makerhqsac/piprog/images/assembly4.png

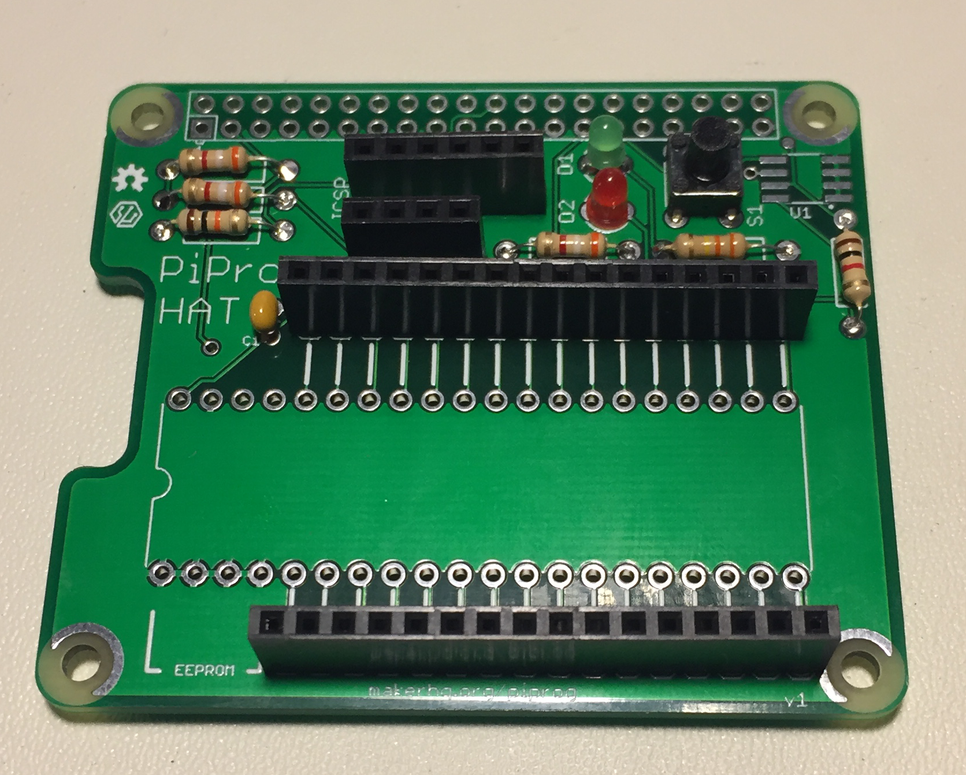
images/assembly4.png
