makerhqsac/piprog/images/assembly2b.png

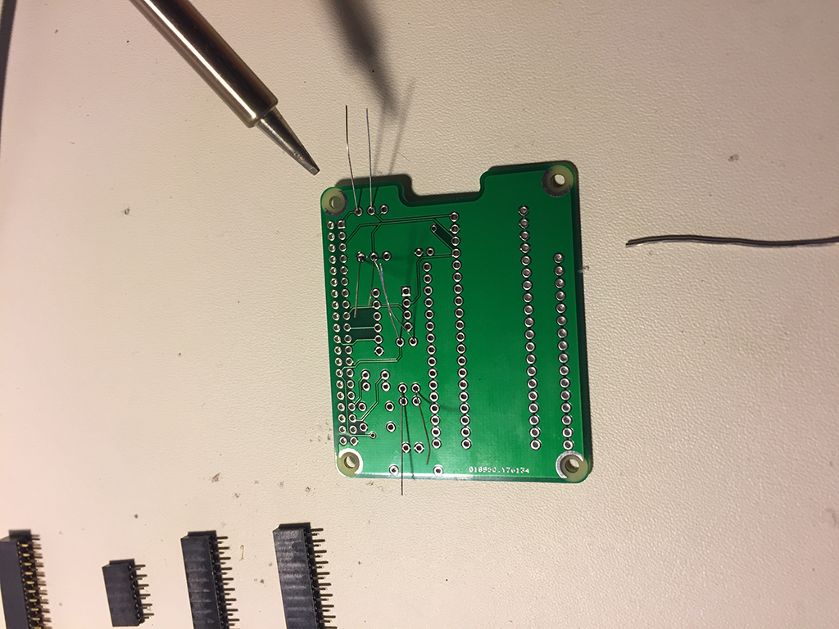
images/assembly2b.png
