makerhqsac/piprog/README.md

# piprog
PiProg - Raspberry Pi EEPROM and ICSP Programmer HAT
