makerhqsac/piprog/hardware/piprog_v1.pdf

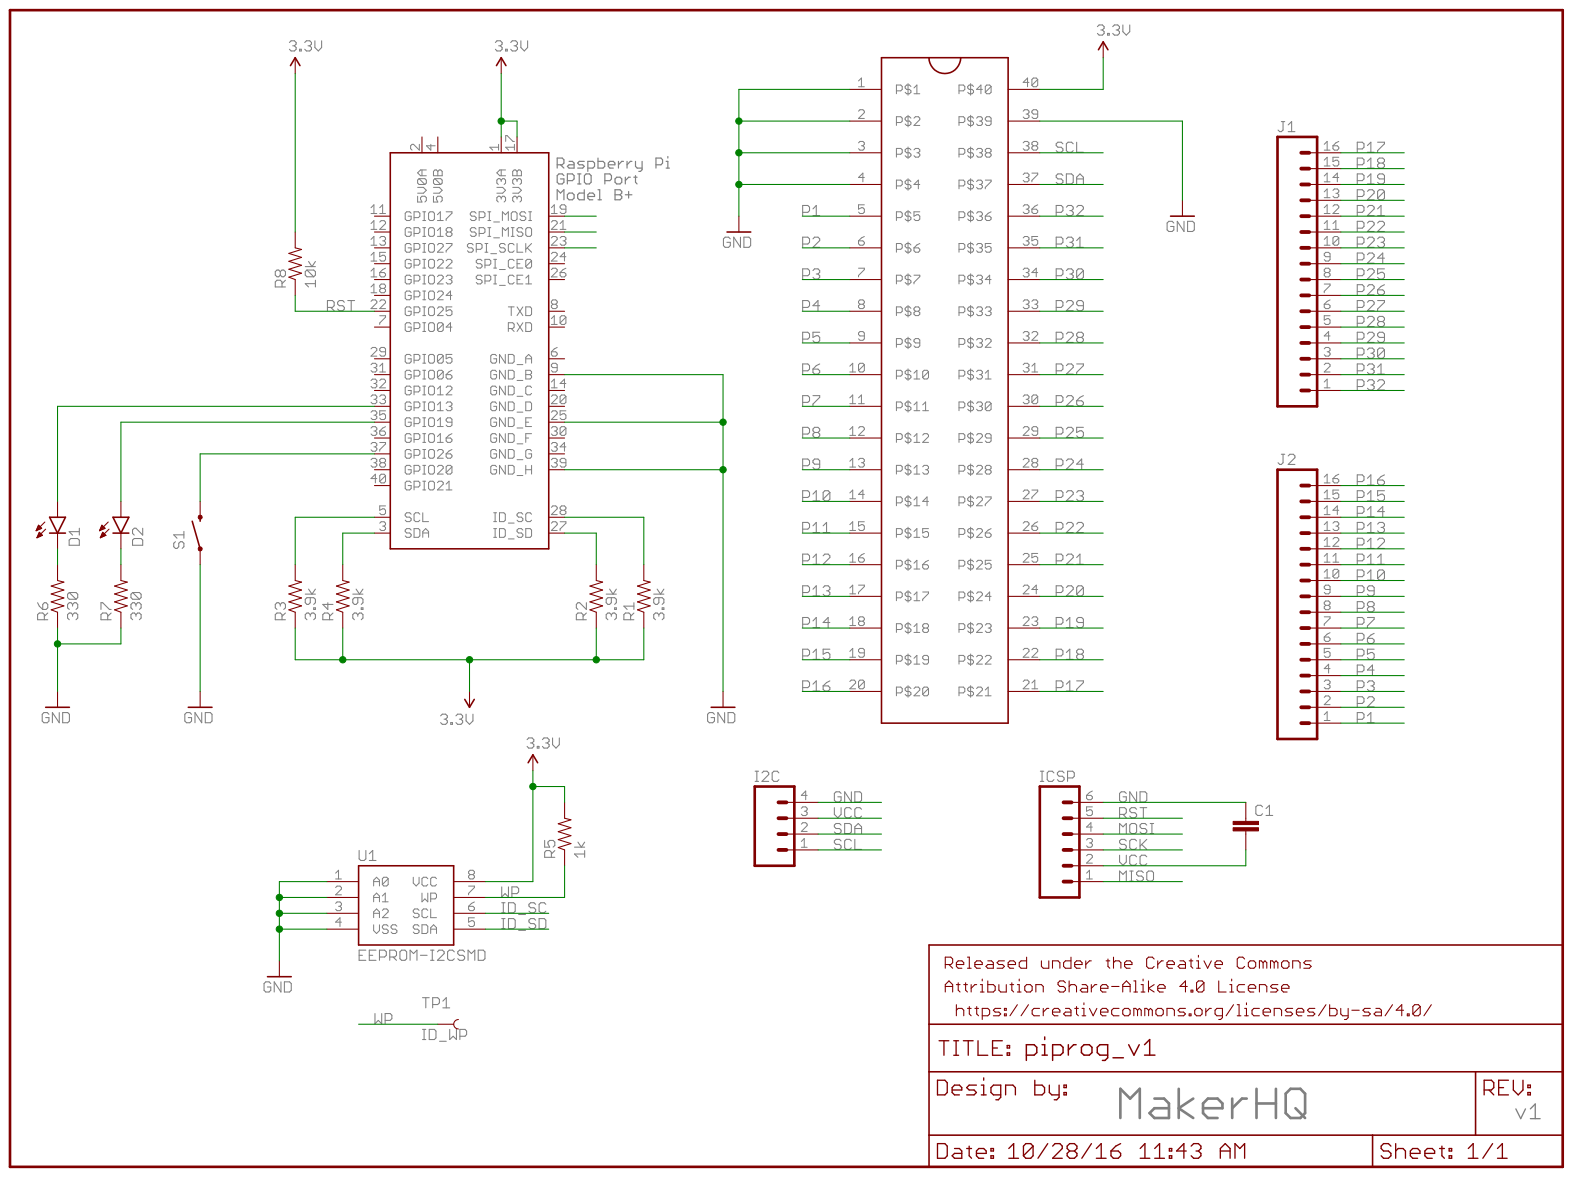
[picture p3: page 1]
