makerhqsac/piprog/hardware/piprog_v1.brd

## EAGLE design hardware/piprog_v1.brd (2016-10-31)

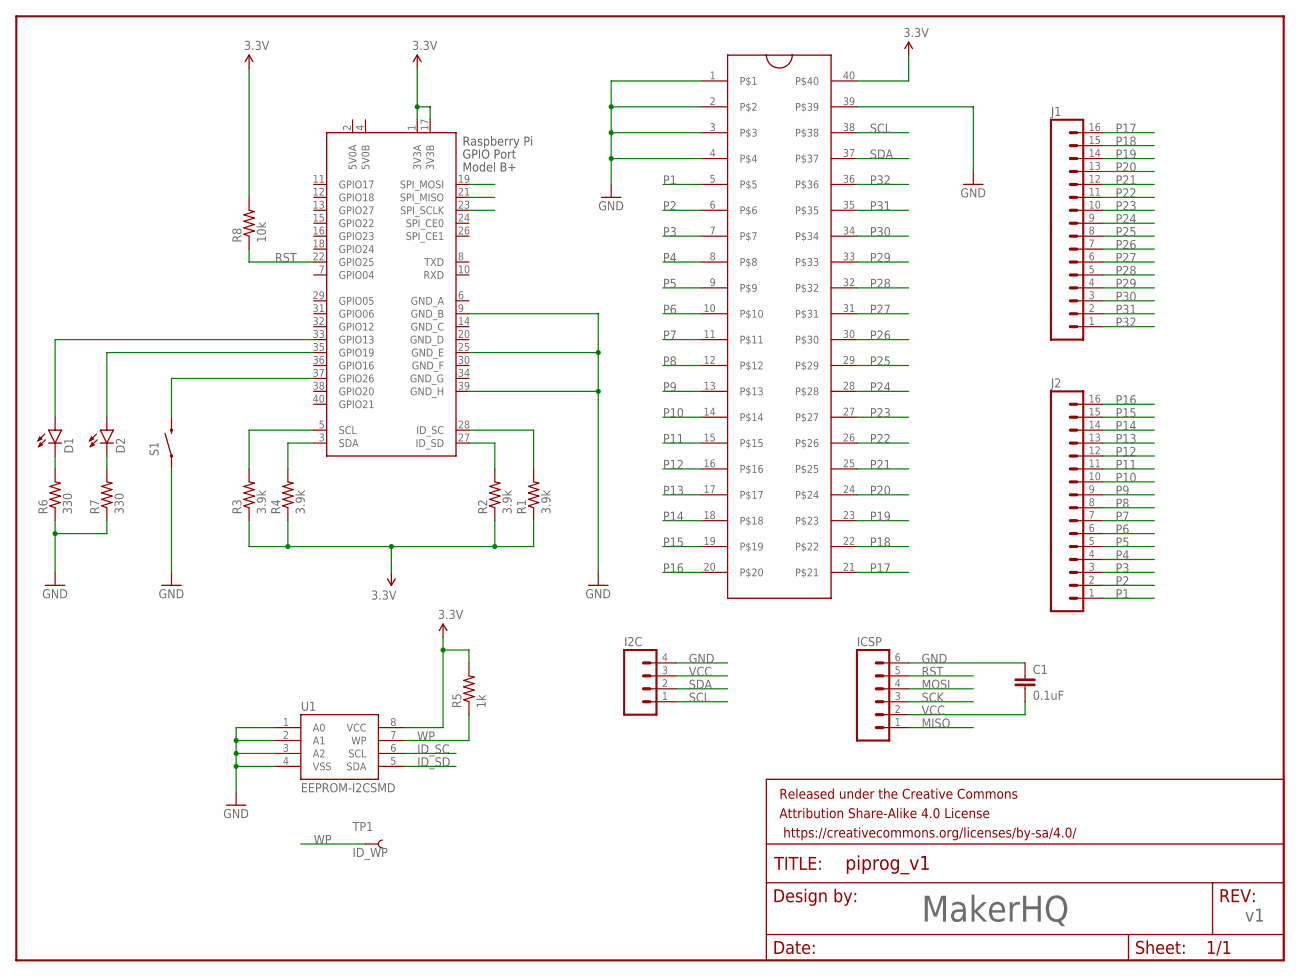
[picture p4: schematic piprog_v1.sch]

Parts:
C1: 0.1uF; CAP-PTH-SMALL
D1, D2: LED3MM
FRAME1: FRAME-LETTERNO_PACKAGE; DUMMY
I2C: M04PTH; 1X04
ICSP: M06SILK_FEMALE_PTH; 1X06
J1, J2: M16PTH; 1X16
R1, R2, R3, R4: 3.9k; AXIAL-0.4
R5: 1k; AXIAL-0.4
R6, R7: 330; AXIAL-0.4
R8: 10k; AXIAL-0.4
S1: SWITCH-MOMENTARY-2PTH; TACTILE-PTH
TP1: ID_WP; PAD.03X.04
U1: EEPROM-I2CSMD; SO08
U$2: ZIFSOCKET-40-6DIL40-6-ZIF_SOCKET; DIL40-6-ZIF_SOCKET
X1: RASPI_BOARD_B+#_HD; RASPI_BOARD_B+HAT_DF

Connections:
5V0A: X1.2 (5V0A)
5V0B: X1.4 (5V0B)
GND: C1.1, I2C.4, ICSP.6, R6.P$1 (1), R7.P$1 (1), S1.1, U1.1 (A0), U1.2 (A1), U1.3 (A2), U1.4 (VSS), U$2.1, U$2.2, U$2.3, U$2.4, U$2.39, X1.9 (GND_B), X1.25 (GND_E), X1.39 (GND_H)
GND_A: X1.6 (GND_A)
GND_C: X1.14 (GND_C)
GND_D: X1.20 (GND_D)
GND_F: X1.30 (GND_F)
GND_G: X1.34 (GND_G)
ID_SC: R1.P$2 (2), U1.6 (SCL), X1.28 (ID_SC)
ID_SD: R2.P$2 (2), U1.5 (SDA), X1.27 (ID_SD)
MISO: ICSP.1, X1.21 (SPI_MISO)
MOSI: ICSP.4, X1.19 (SPI_MOSI)
unnamed: D2.K (C), R7.P$2 (2)
unnamed: D1.K (C), R6.P$2 (2)
unnamed: D1.A, X1.33 (GPIO13)
unnamed: D2.A, X1.35 (GPIO19)
unnamed: S1.3 (2), X1.37 (GPIO26)
P1: J2.1, U$2.5
P2: J2.2, U$2.6
P3: J2.3, U$2.7
P4: J2.4, U$2.8
P5: J2.5, U$2.9
P6: J2.6, U$2.10
P7: J2.7, U$2.11
P8: J2.8, U$2.12
P9: J2.9, U$2.13
P10: J2.10, U$2.14
P11: J2.11, U$2.15
P12: J2.12, U$2.16
P13: J2.13, U$2.17
P14: J2.14, U$2.18
P15: J2.15, U$2.19
P16: J2.16, U$2.20
P17: J1.16, U$2.21
P18: J1.15, U$2.22
P19: J1.14, U$2.23
P20: J1.13, U$2.24
P21: J1.12, U$2.25
P22: J1.11, U$2.26
P23: J1.10, U$2.27
P24: J1.9, U$2.28
P25: J1.8, U$2.29
P26: J1.7, U$2.30
P27: J1.6, U$2.31
P28: J1.5, U$2.32
P29: J1.4, U$2.33
P30: J1.3, U$2.34
P31: J1.2, U$2.35
P32: J1.1, U$2.36
RST: ICSP.5, R8.P$1 (1), X1.22 (GPIO25)
SCK: ICSP.3, X1.23 (SPI_SCLK)
SCL: I2C.1, R3.P$2 (2), U$2.38, X1.5 (SCL)
SDA: I2C.2, R4.P$2 (2), U$2.37, X1.3 (SDA)
VCC: C1.2, I2C.3, ICSP.2, R1.P$1 (1), R2.P$1 (1), R3.P$1 (1), R4.P$1 (1), R5.P$2 (2), R8.P$2 (2), U1.8 (VCC), U$2.40, X1.1 (3V3A), X1.17 (3V3B)
WP: R5.P$1 (1), TP1.P$1, U1.7 (WP)

Notes on the sheet:
MakerHQ

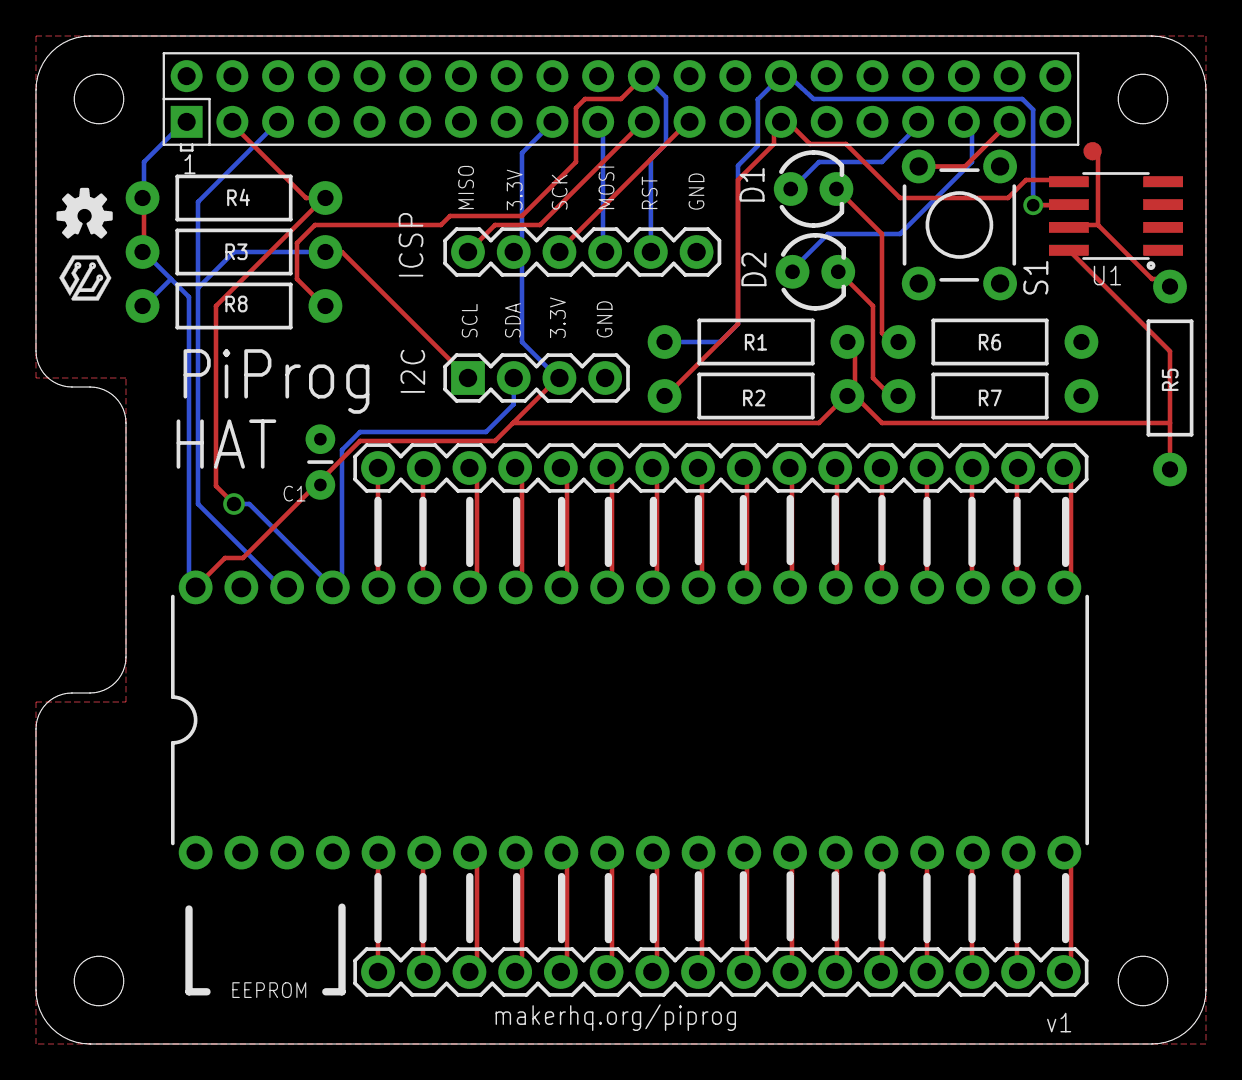
[picture p5: board piprog_v1.brd from above]

Board: 2 copper layers, 65.0 x 56.0 mm, 23 parts (0 on the bottom side), 48 nets.

Other parts of the board:
U$1: OSHW-LOGO-S
U$3: MAKERHQ_LOGO_S
