makerhqsac/piprog/images/assembly0.png

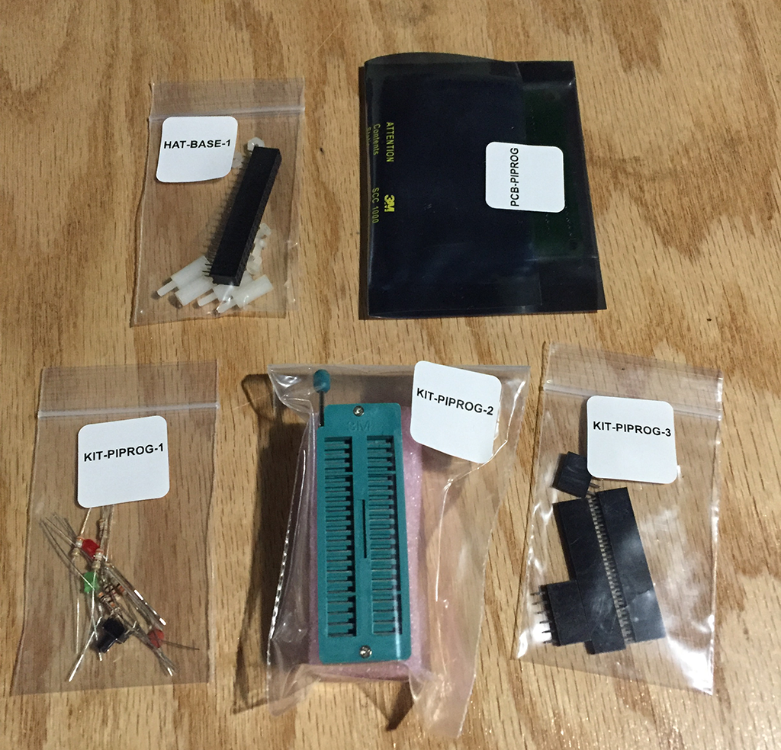
images/assembly0.png
