makerhqsac/piprog/images/assembly2a.png

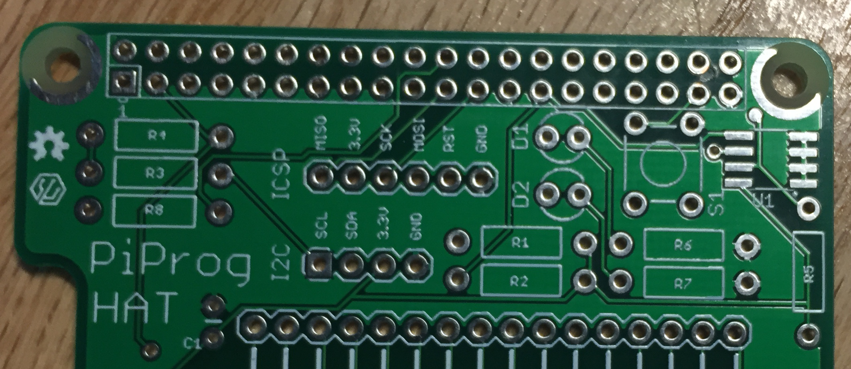
images/assembly2a.png
