makerhqsac/piprog/images/assembly3.png

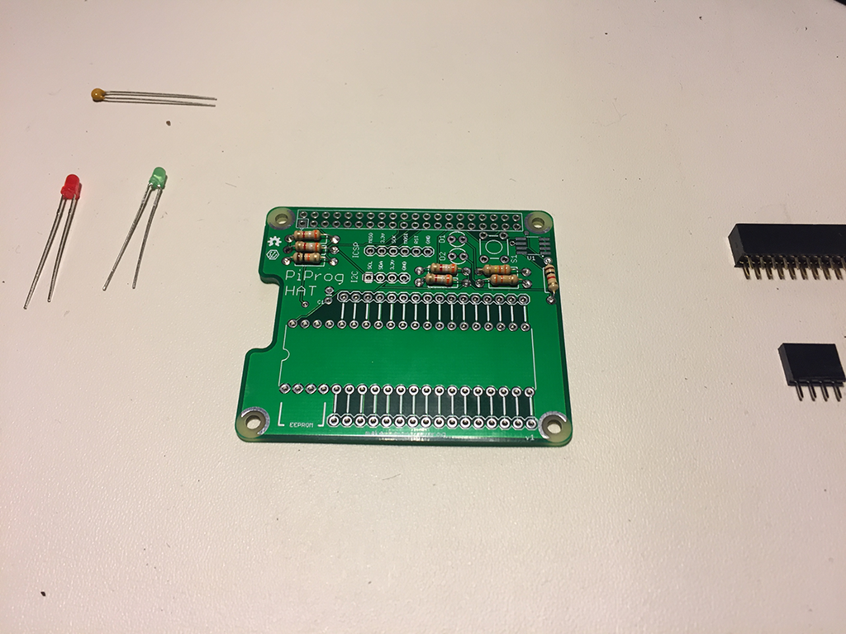
images/assembly3.png
