makerhqsac/piprog/images/assembly5.png

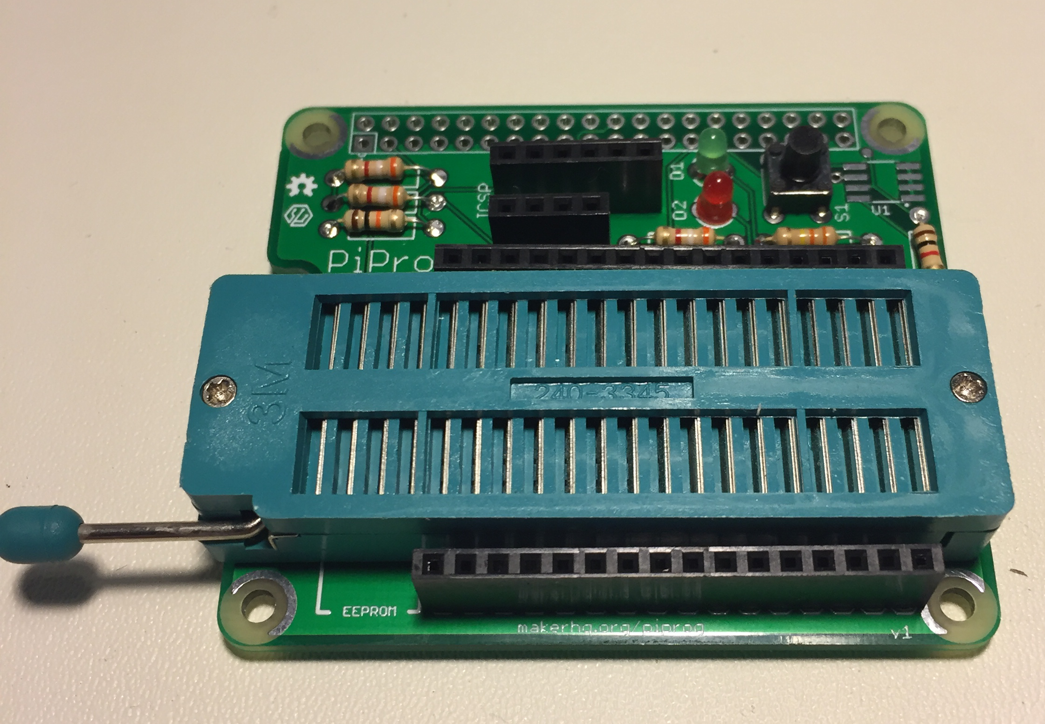
images/assembly5.png
