makerhqsac/piprog/(commit log)

2016-10-26 Initial files
    [piprog_v1.brd, piprog_v1.sch]
2016-10-28 changed reset pin, add reset pullup
    [piprog_v1.brd, piprog_v1.sch]
2016-10-31 Set fuses after flashing, if fuse settings are present
    [piprog_v1.brd]
2016-11-18 Fix hat write utility
    [hat_write.py]
2017-04-18 add assembly images
